brentru/greenhousecontroller/pcb/11_21 PCB/BOM.xlsx

Sheet: BOM (FINAL)
Category | Value | Package | Vendor | Part Number | Board Designation | Quantity | Unit Price | Total Cost
Capacitor | 0.01uF | C0805 | Digikey | 445-6947-1-ND (http://www.digikey.com/product-detail/en/CGA4C2C0G1H103J060AA/445-6947-1-ND/2672965) | C9 | 1 | $0.32 | $0.32
LED | Green | LED0805 | Digikey | 732-4986-1-ND (http://www.digikey.com/product-detail/en/150080VS75000/732-4986-1-ND/4489922) | LED7,LED8 | 2 | $0.29 | $0.58
LED | Blue | LED0805 | Digikey | 732-4982-1-ND (http://www.digikey.com/product-detail/en/150080BS75000/732-4982-1-ND/4489910) | LED3,LED4,LED5,LED6 | 4 | $0.29 | $1.16
LED | Red | LED0805 | Digikey | 732-4984-1-ND (http://www.digikey.com/product-detail/en/150080RS75000/732-4984-1-ND/4489916) | LED1,LED2 | 2 | $0.29 | $0.58
Resistor | 22Ω | R0805 | Digikey | P22.0CCT-ND (http://www.digikey.com/product-detail/en/ERJ-6ENF22R0V/P22.0CCT-ND/1746835) | R1,R2 | 2 | $0.10 | $0.20
Test | TPTP16SQ | Test | Digikey | A106144CT-ND (http://www.digikey.com/product-detail/en/1625854-2/A106144CT-ND/3477801) | TP1-TP23 | 25 | $0.23 | $5.70
 |  |  |  |  |  | Total Cost |  | $8.54
 |  |  |  |  |  | Cost for 1 Board |  | Figure It Out
 |  |  |  | COPY OF DIGIKEY CART

Sheet: Power Board
Category | Value | Package | Vendor | Part Number | Board Designation | Board | Quantity | Unit Price | Unit Cost | Checked
Resistor | 150 Ohm | R0805 | Digikey | RMCF0805JT150RCT-ND (http://www.digikey.com/product-detail/en/stackpole-electronics-inc/RMCF0805JT150R/RMCF0805JT150RCT-ND/1942541) | R1,R2, R4 | GreenHouse | 3 | $0.10 | $0.30 | yes
Resistor | 1k | R0805 | Digikey | RC0805JR-071KL (http://www.digikey.com/product-detail/en/yageo/RC0805JR-071KL/311-1.0KARCT-ND/731165) | R3,R7,R9,R12,R14,R15 | GreenHouse | 6 | $0.10 | $0.60 | yes
Resistor | 240 Ohm | R0805 | Digikey | RMCF0805JT240RCT-ND (http://www.digikey.com/product-detail/en/stackpole-electronics-inc/RMCF0805JT240R/RMCF0805JT240RCT-ND/1942545) | R8,R11 | GreenHouse | 2 | $0.10 | $0.20 | yes
Resistor | 3k | R0805 | Digikey | RMCF0805JT3K00CT-ND (http://www.digikey.com/product-detail/en/stackpole-electronics-inc/RMCF0805JT3K00/RMCF0805JT3K00CT-ND/1942566) | R13 | GreenHouse | 1 | $0.10 | $0.10 | yes
Resistor | 10k | R0805 | Digikey | RMCF0805JT10K0CT-ND (http://www.digikey.com/product-detail/en/stackpole-electronics-inc/RMCF0805JT10K0/RMCF0805JT10K0CT-ND/1942577) | R2,R5,R6 | GreenHouse | 3 | $0.10 | $0.30 | yes
Zener Diode | 15V | SOD-323F | Digikey | DZ2J150M0LCT-ND (http://www.digikey.com/product-detail/en/panasonic-electronic-components/DZ2J150M0L/DZ2J150M0LCT-ND/2269089) | D10 | GreenHouse | 1 | $0.10 | $0.10 | yes
Diode | 80V, 100mA | SOD-523 | Digikey | DA2S10100LCT-ND (http://www.digikey.com/product-detail/en/panasonic-electronic-components/DA2S10100L/DA2S10100LCT-ND/2193675) | D1,D2,D3,D4,D5,D6,D7,D11 | GreenHouse | 8 | $0.10 | $0.80 | yes
Diode | 75V | SOD-323F | Digikey | 1N4148WSFSCT-ND (http://www.digikey.com/product-detail/en/fairchild-semiconductor/1N4148WS/1N4148WSFSCT-ND/1873821) | D9 | GreenHouse | 1 | $0.15 | $0.15 | yes
Capacitor | 0.1uF | C0805 | Digikey | 311-1361-1-ND (http://www.digikey.com/product-detail/en/yageo/CC0805ZRY5V9BB104/311-1361-1-ND/2103145) | C4,C6,C7 | GreenHouse | 3 | $0.10 | $0.30 | yes
Capacitor | 1.0uF | C0805 | Digikey | 311-1365-1-ND (http://www.digikey.com/product-detail/en/yageo/CC0805KKX7R7BB105/311-1365-1-ND/2103149) | C3,C5 | GreenHouse | 2 | $0.10 | $0.20 | yes
Capacitor | 20.0pF | C0805 | Digikey | 1276-1829-1-ND (http://www.digikey.com/product-detail/en/samsung-electro-mechanics-america-inc/CL21C200JBANNNC/1276-1829-1-ND/3889915) | C1,C2 | GreenHouse | 2 | $0.10 | $0.20 | yes
Semiconductor | 30V, 60mA | SMD-DIP-6 | Mouser | 4N27S-M (http://www.mouser.com/ProductDetail/Fairchild-Semiconductor/4N27SM/?qs=6uASyQ2j9sdvrBgMHZPeqA%3D%3D) | OK1,OK2 | GreenHouse | 2 | $0.56 | $1.12 | yes
Transistor | 40V, 600 mA | SOT-23-3 | Digikey | MMBT2222A-FDICT-ND (http://www.digikey.com/product-detail/en/diodes-incorporated/MMBT2222A-7-F/MMBT2222A-FDICT-ND/815723) | Q1 | GreenHouse | 1 | $0.13 | $0.13 | yes
Push Button |  | SPST | Digikey | CW181-ND (http://www.digikey.com/product-detail/en/cw-industries/GPTS203211B/CW181-ND/3190590) | SW1 | GreenHouse | 1 | $0.74 | $0.74 | yes
Dual Full-Bridge Driver | 46V, 2A | 15-pin | Newark | L298N (http://www.newark.com/stmicroelectronics/l298n/motor-driver-full-bridge-2a-multiwatt15/dp/32M1527) | IC4 | GreenHouse | 1 | $8.85 | $8.85 | yes
Voltage Regulator | 33V-40V, 24V/1A | 3-pin | Newark | 29C4844 (http://www.newark.com/nte-electronics/nte972/linear-voltage-regulator-24v-to/dp/29C4844?rpsku=rel1%3A05H6137) | IC2 | GreenHouse | 1 | $1.55 | $1.55 | yes
Relay | 12VDC | Through-hole | Digikey | Z1015-ND (http://www.digikey.com/product-detail/en/omron-electronics-inc-emc-div/G5LE-1-DC12/Z1015-ND/280366?WT.srch=1) | K2 | GreenHouse | 1 | $1.33 | $1.33 | yes
Power Jack |  | 2.1mm/5.5mm | Digikey | EJ503A-ND (http://www.digikey.com/product-detail/en/mpd-memory-protection-devices/EJ503A/EJ503A-ND/5431753) | J1 | GreenHouse | 1 | $2.23 | $2.23 | yes
Screw Terminal |  | 3.5mm | Digikey | ED2636-ND (http://www.digikey.com/product-detail/en/on-shore-technology-inc/OSTTE030161/ED2636-ND/614585) | J2,J4,J5,J6,J7 | GreenHouse | 5 | $0.64 | $3.20 | yes
Screw Terminal |  | 5mm | Digikey | ED2601-ND (http://www.digikey.com/product-detail/en/on-shore-technology-inc/OSTTC030162/ED2601-ND/614550) | J3 | GreenHouse | 1 | $0.59 | $0.59 | yes
AVR ISP Header |  | 2x3-pin | Adafruit | #1465 (https://www.adafruit.com/products/1465?gclid=CIKw293bsNACFZBLDQodAlACig) | ICSP-PROG-HEADER | GreenHouse | 1 | $0.95 | $0.95 | yes
Crystal | 16MHz | HC-49 | Digikey | 535-10226-1-ND (http://www.digikey.com/product-detail/en/abracon-llc/ABLS-16.000MHZ-B4-T/535-10226-1-ND/2184261) | X1 | GreenHouse | 1 | $0.25 | $0.25 | yes
LED |  | CT | Digikey | 160-1423-1-ND (http://www.digikey.com/product-detail/en/lite-on-inc/LTST-C171GKT/160-1423-1-ND/386792) | LED3,LED4,LED5 | GreenHouse | 3 | $0.29 | $0.87 | yes
Heatsink |  | TO220 L298N | Amazon | 14004198 (https://www.amazon.com/12pcs-Aluminum-Heat-TO220-L298N/dp/B008XCNB2Q) |  | GreenHouse | 1 | $3.44 | $3.44 | yes
Female Header |  | 8x1-pin | Digikey | 609-3559-ND (http://www.digikey.com/product-detail/en/amphenol-fci/75915-308LF/609-3559-ND/1523940) | SV2,SV3 | GreenHouse | 2 | $1.16 | $2.32 | yes
FTDI Serial Header |  |  |  | #00834 (http://www.4uconnector.com/online/SearchPro.asp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) |  | GreenHouse | 1 | $1.00 | $1.00 | yes
 |  |  |  |  |  |  |  | Total | $31.82
