brentru/greenhousecontroller/pcb/11_21 PCB/ghc-silk.brd

## EAGLE design pcb/11_21 PCB/ghc-silk.brd (2016-11-22)

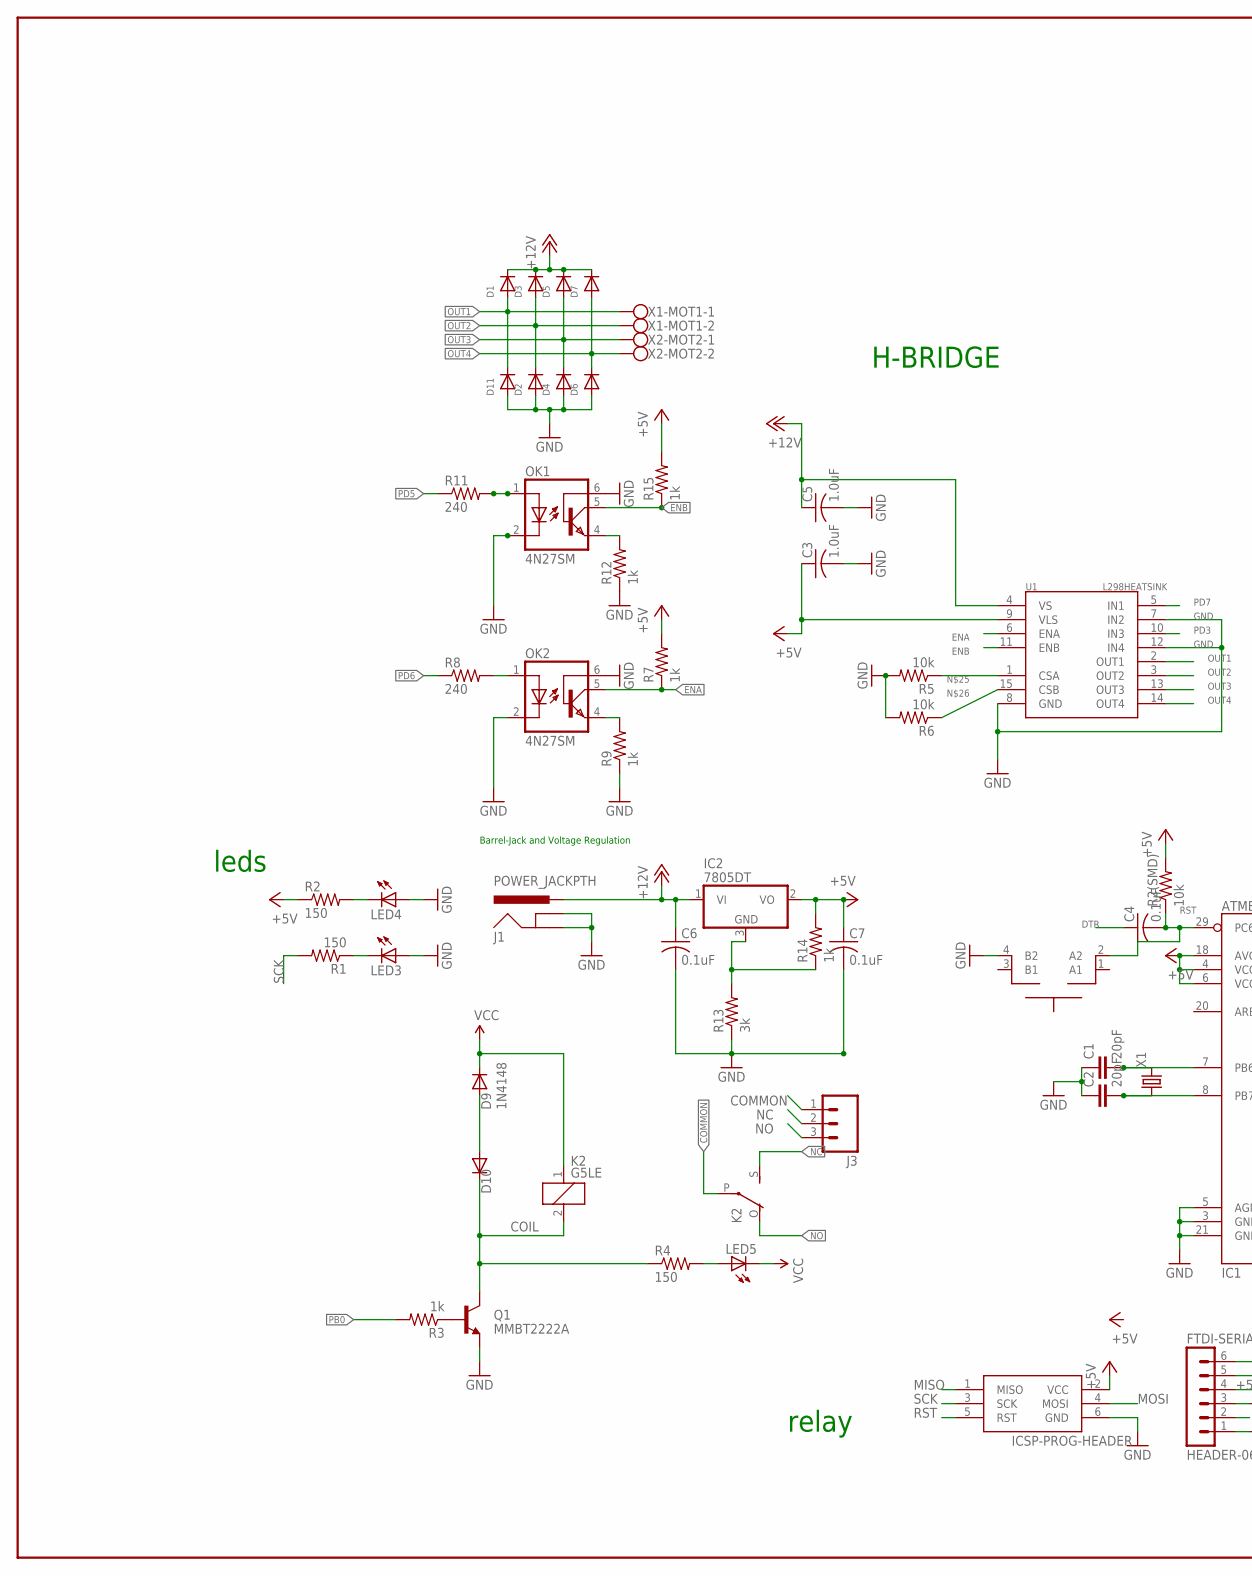
[picture p1: schematic ghc-silk.sch, part in row 1, column 1]

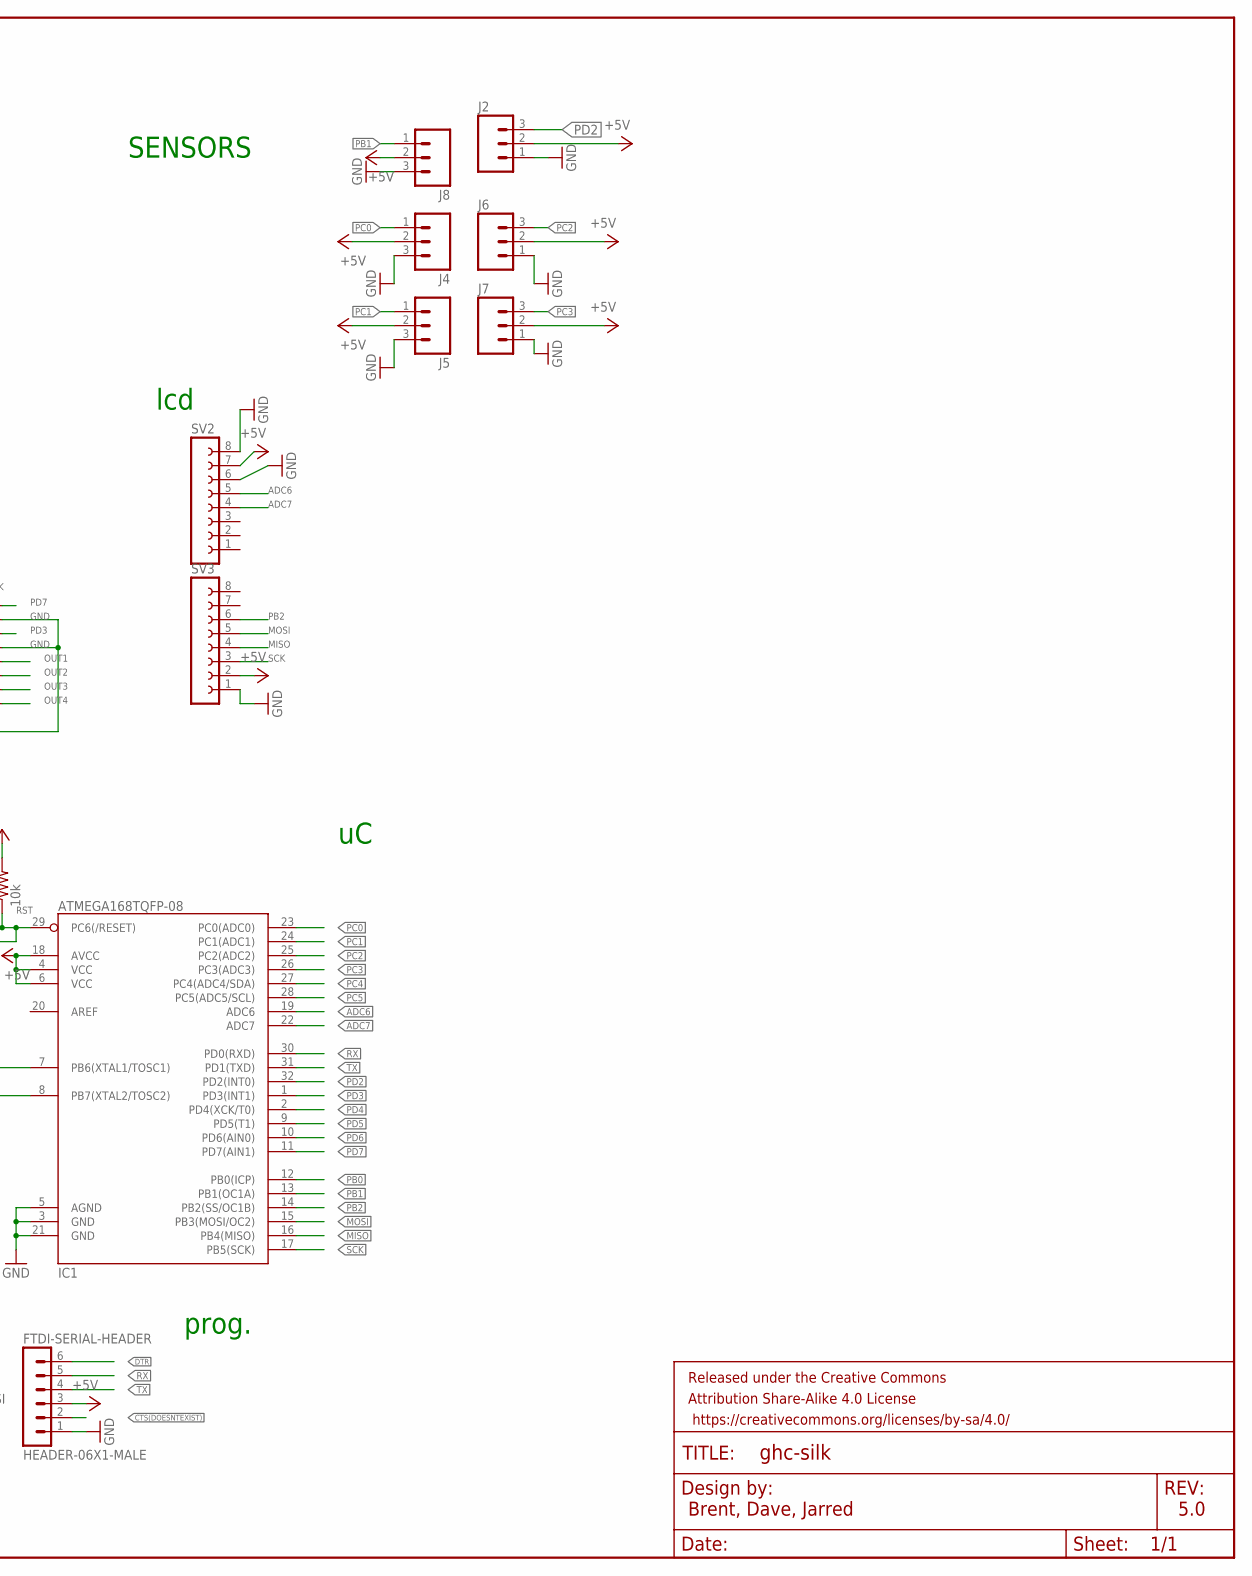
[picture p2: schematic ghc-silk.sch, part in row 1, column 2]

Parts:
C1, C2: 20pF; C0805
C3, C5: 1.0uF; C0805
C4, C6, C7: 0.1uF; C0805
D1, D2, D3, D4, D5, D6, D7, D11: DIODESOD-523; SOD-523
D9: 1N4148; SOD-323F
D10: Zener; SOD-323F
FRAME1: FRAME-LEDGER; CREATIVE_COMMONS
FTDI-SERIAL-HEADER: HEADER-06X1-MALE; 06X1-PTH
IC1: ATMEGA168TQFP-08; TQFP32-08
IC2: 7805DT; TO252
ICSP-PROG-HEADER: AVRISP-6; AVRISP
J1: POWER_JACKPTH; POWER_JACK_PTH
J2, J4, J5, J6, J7, J8: M03SCREW_LOCK; SCREWTERMINAL-3.5MM-3_LOCK.007S
J3: M03-SCREW-5MM; SCREWTERMINAL-5MM-3
K2: G5LE
LED3, LED4, LED5: LEDCHIP-LED0805; CHIP-LED0805
OK1, OK2: 4N27SM; DIL6-SMD
Q1: MMBT2222A; SOT23-3
R1, R2, R4: 150; M0805
R2(SMD), R5, R6: 10k; M0805
R3, R7, R9, R12, R14, R15: 1k; M0805
R8, R11: 240; M0805
R13: 3k; 0402-RES
SV2, SV3: FE08-1; FE08
SW2: MOMENTARYBUTTON; SPST_NO_SMD
U1: L298HEATSINK; MULTIWATT15_6400BGHEATSINK
X1: CRYSTALHC49UP; HC49UP
X1-MOT1, X2-MOT2: W237-102

Connections:
+5V: C3.1, C7.1, FTDI-SERIAL-HEADER.3, IC1.4 (VCC), IC1.6 (VCC), IC1.18 (AVCC), IC2.2 (VO), ICSP-PROG-HEADER.2 (VCC), J2.2, J4.2, J5.2, J6.2, J7.2, J8.2, R2.1, R2(SMD).2, R7.2, R14.2, R15.2, SV2.7, SV3.2, U1.9 (VLS)
+12V: C5.1, C6.1, D1.K (C), D3.K (C), D5.K (C), D7.K (C), IC2.1 (VI), J1.PWR, U1.4 (VS)
ADC6: IC1.19 (ADC6), SV2.5
ADC7: IC1.22 (ADC7), SV2.4
COIL: D10.C, K2.2, Q1.3 (C), R4.1
COMMON: J3.1, K2.P
CTS(DOESNTEXIST): FTDI-SERIAL-HEADER.2
DIODENODE: D9.A, D10.A
DTR: C4.1, FTDI-SERIAL-HEADER.6
ENA: OK2.5 (COL), R7.1, U1.6 (ENA)
ENB: OK1.5 (COL), R15.1, U1.11 (ENB)
GND: C1.1, C2.1, C3.2, C5.2, C6.2, C7.2, D2.A, D4.A, D6.A, D11.A, FTDI-SERIAL-HEADER.1, IC1.3 (GND), IC1.5 (AGND), IC1.21 (GND), ICSP-PROG-HEADER.6 (GND), J1.GND, J1.GNDBREAK, J2.1, J4.3, J5.3, J6.1, J7.1, J8.3, LED3.A, LED4.A, OK1.2 (C), OK1.6 (BAS), OK2.2 (C), OK2.6 (BAS), Q1.2 (E), R5.2, R6.2, R9.1, R12.1, R13.1, SV2.6, SV2.8, SV3.1, SW2.4 (B2), U1.7 (IN2), U1.8 (GND), U1.12 (IN4)
MISO: IC1.16 (PB4(MISO)), ICSP-PROG-HEADER.1 (MISO), SV3.4
MOSI: IC1.15 (PB3(MOSI/OC2)), ICSP-PROG-HEADER.4 (MOSI), SV3.5
unnamed: OK2.1 (A), R8.2
unnamed: LED4.C, R2.2
unnamed: LED5.A, R4.2
unnamed: OK2.4 (EMI), R9.2
unnamed: Q1.1 (B), R3.1
unnamed: IC2.3 (GND), R13.2, R14.1
unnamed: OK1.1 (A), R11.2
unnamed: LED3.C, R1.1
unnamed: C1.2, IC1.7 (PB6(XTAL1/TOSC1)), X1.2
unnamed: C2.2, IC1.8 (PB7(XTAL2/TOSC2)), X1.1
unnamed: OK1.4 (EMI), R12.2
unnamed: R5.1, U1.1 (CSA)
unnamed: R6.1, U1.15 (CSB)
NC: J3.2, K2.S
NO: J3.3, K2.O
OUT1: D1.A, D11.K (C), U1.2 (OUT1), X1-MOT1.1
OUT2: D2.K (C), D3.A, U1.3 (OUT2), X1-MOT1.2
OUT3: D4.K (C), D5.A, U1.13 (OUT3), X2-MOT2.1
OUT4: D6.K (C), D7.A, U1.14 (OUT4), X2-MOT2.2
PB0: IC1.12 (PB0(ICP)), R3.2
PB1: IC1.13 (PB1(OC1A)), J8.1
PB2: IC1.14 (PB2(SS/OC1B)), SV3.6
PC0: IC1.23 (PC0(ADC0)), J4.1
PC1: IC1.24 (PC1(ADC1)), J5.1
PC2: IC1.25 (PC2(ADC2)), J6.3
PC3: IC1.26 (PC3(ADC3)), J7.3
PC4: IC1.27 (PC4(ADC4/SDA))
PC5: IC1.28 (PC5(ADC5/SCL))
PD2: IC1.32 (PD2(INT0)), J2.3
PD3: IC1.1 (PD3(INT1)), U1.10 (IN3)
PD4: IC1.2 (PD4(XCK/T0))
PD5: IC1.9 (PD5(T1)), R11.1
PD6: IC1.10 (PD6(AIN0)), R8.1
PD7: IC1.11 (PD7(AIN1)), U1.5 (IN1)
RST: C4.2, IC1.29 (PC6(/RESET)), ICSP-PROG-HEADER.5 (RST), R2(SMD).1, SW2.2 (A2)
RX: FTDI-SERIAL-HEADER.5, IC1.30 (PD0(RXD))
SCK: IC1.17 (PB5(SCK)), ICSP-PROG-HEADER.3 (SCK), R1.2, SV3.3
TX: FTDI-SERIAL-HEADER.4, IC1.31 (PD1(TXD))
VCC: D9.C, K2.1, LED5.C

Notes on the sheet:
Barrel-Jack and Voltage Regulation
H-BRIDGE
lcd
SENSORS
prog.
relay
leds
5.0
Brent, Dave, Jarred

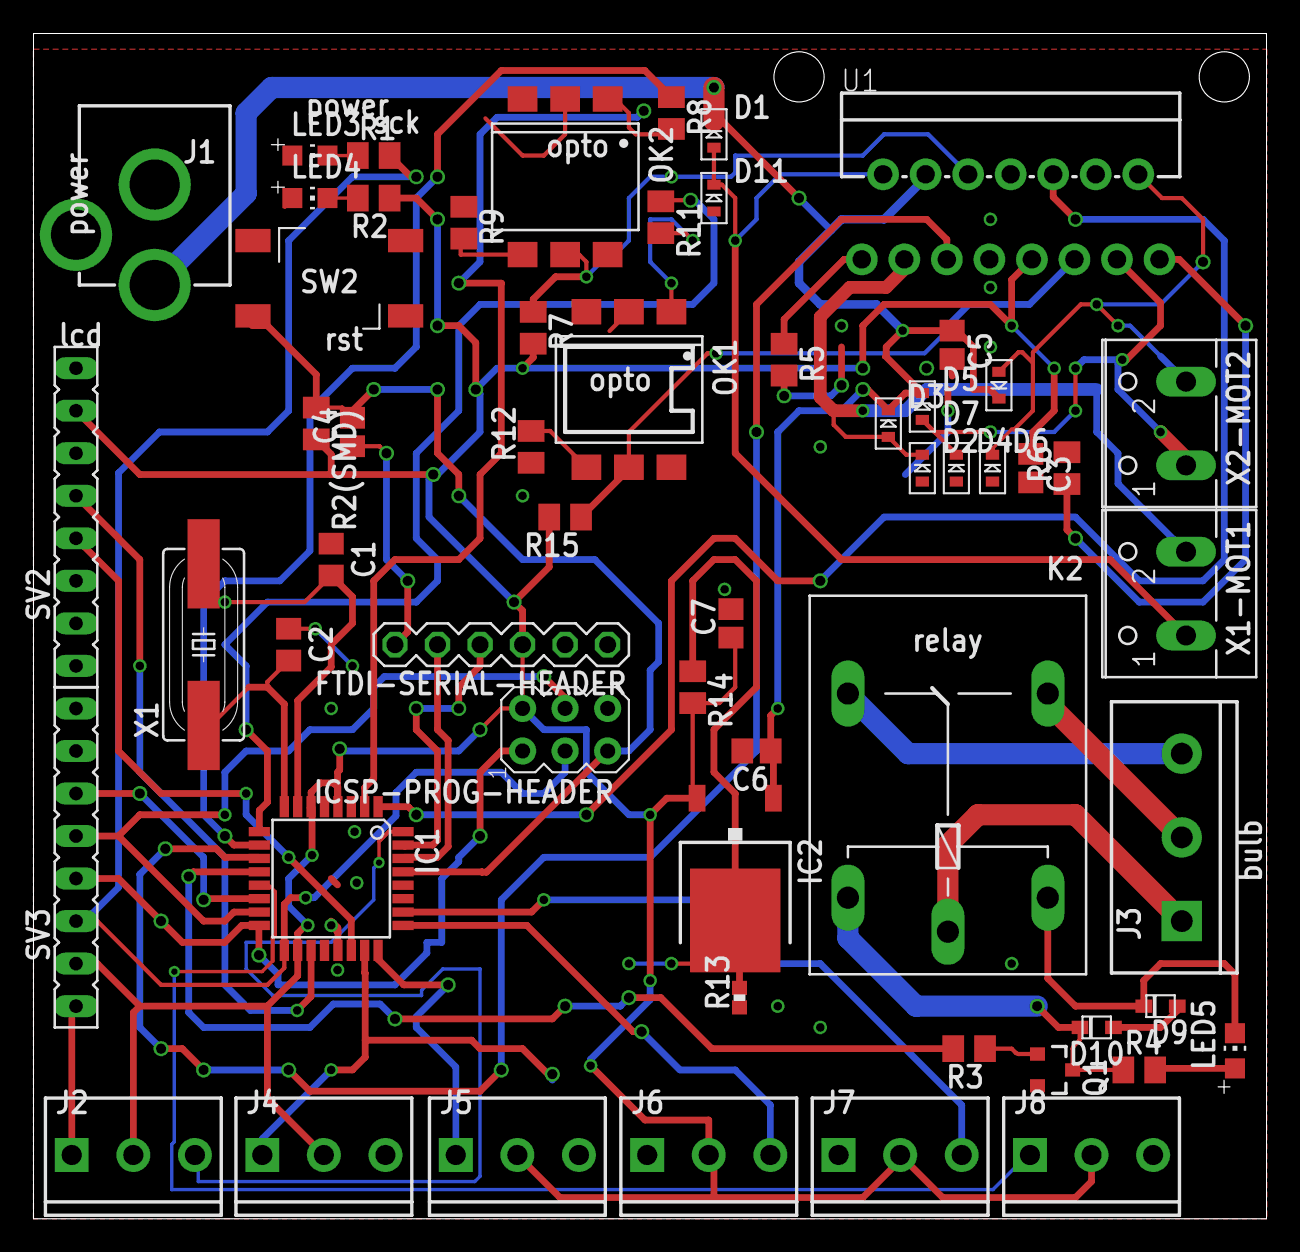
[picture p3: board ghc-silk.brd from above]

Board: 2 copper layers, 73.6 x 70.8 mm, 59 parts (0 on the bottom side), 49 nets.
