brentru/greenhousecontroller/DBJ/sb/sandbox/DBJ/outdated/greenhousectrl-lab.brd

## EAGLE design greenhousecontroller-master/DBJ/sb/sandbox/DBJ/outdated/greenhousectrl-lab.brd (2016-10-29, an earlier design)

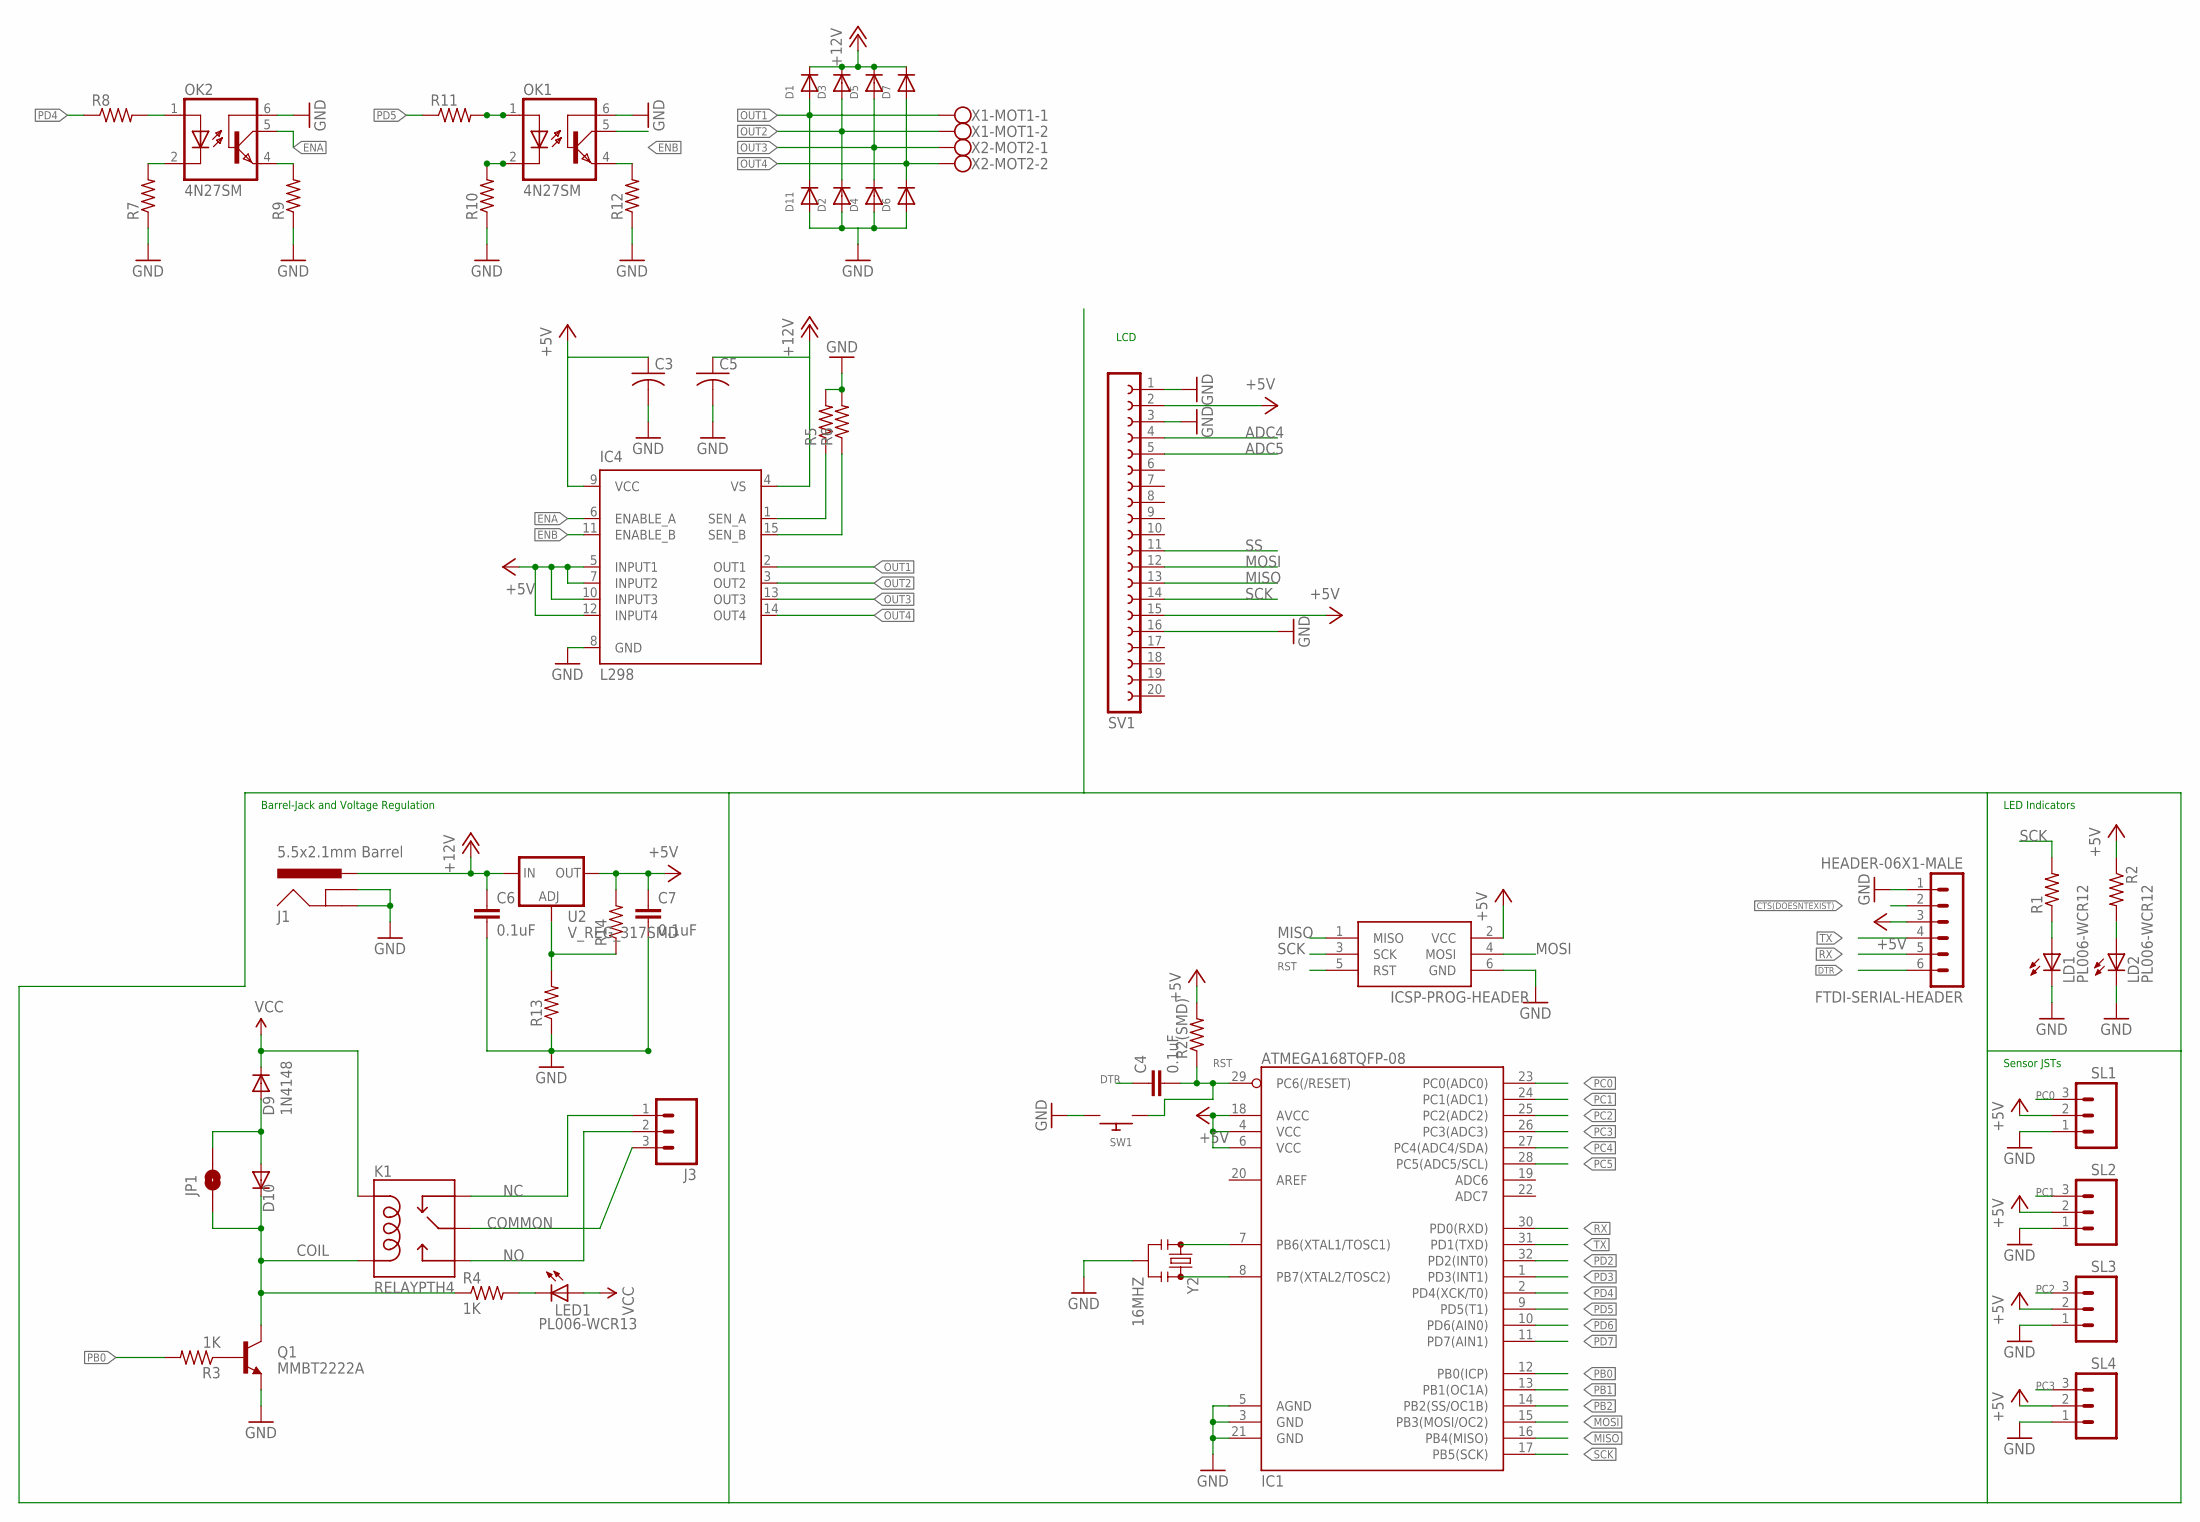
[picture p4: schematic greenhousectrl-lab.sch]

Parts:
C3, C5: C-US025-024X044; C025-024X044
C4, C6, C7: 0.1uF; 0603-CAP
D1, D2, D3, D4, D5, D6, D7, D11: DIODESOD-523; SOD-523
D9: 1N4148; SOD-323F
D10: Zener; SOD-323F
FTDI-SERIAL-HEADER: HEADER-06X1-MALE; 06X1-PTH
IC1: ATMEGA168TQFP-08; TQFP32-08
IC4: L298; MULTIWATT-15
ICSP-PROG-HEADER: AVRISP-6; AVRISP
J1: 5.5x2.1mm Barrel; POWER_JACK_SMD
J3: M03-SCREW-5MM; SCREWTERMINAL-5MM-3
JP1: JUMPER-PAD-2-NOYES_SILK; PAD-JUMPER-2-NO_YES_SILK
K1: RELAYPTH4; RELAY-JZC
LD1, LD2: PL006-WCR12; SOT23
LED1: PL006-WCR13; SOT23
OK1, OK2: 4N27SM; DIL6-SMD
Q1: MMBT2222A; SOT23-3
R1, R2, R2(SMD), R5, R6, R7, R8, R9, R10, R11, R12: R-US_M0805; M0805
R3, R4: 1K; M0805
R13, R14: RESISTOR0402; 0402-RES
SL1, SL2, SL3, SL4: M03; 03P
SV1: FE20-1; FE20
SW1: SWITCH_PUSHBUTTONC&K_KSS; BTN_CK_KSS
U2: V_REG_317SMD; SOT223
X1-MOT1, X2-MOT2: W237-102
Y2: 16MHZ; RESONATOR-SMD

Connections:
+5V: C3.1, C7.1, FTDI-SERIAL-HEADER.3, IC1.4 (VCC), IC1.6 (VCC), IC1.18 (AVCC), IC4.5 (INPUT1), IC4.7 (INPUT2), IC4.9 (VCC), IC4.10 (INPUT3), IC4.12 (INPUT4), ICSP-PROG-HEADER.2 (VCC), R2.1, R2(SMD).2, R14.2, SL1.2, SL2.2, SL3.2, SL4.2, SV1.2, SV1.15, U2.2 (OUT)
+12V: C5.1, C6.1, D1.K (C), D3.K (C), D5.K (C), D7.K (C), IC4.4 (VS), J1.VIN0 (PWR), U2.3 (IN)
ADC4: SV1.4
ADC5: SV1.5
COIL: D10.C, JP1.1, K1.1 (COIL2), Q1.3 (C), R4.1
COMMON: J3.3, K1.4 (MAIN)
CTS(DOESNTEXIST): FTDI-SERIAL-HEADER.2
DIODENODE: D9.A, D10.A, JP1.2
DTR: C4.1, FTDI-SERIAL-HEADER.6
ENA: IC4.6 (ENABLE_A), OK2.5 (COL)
ENB: IC4.11 (ENABLE_B), OK1.5 (COL)
GND: C3.2, C5.2, C6.2, C7.2, D2.A, D4.A, D6.A, D11.A, FTDI-SERIAL-HEADER.1, IC1.3 (GND), IC1.5 (AGND), IC1.21 (GND), IC4.8 (GND), ICSP-PROG-HEADER.6 (GND), J1.GND (GNDBREAK), J1.P$4 (GND), LD1.3 (C), LD2.3 (C), OK1.6 (BAS), OK2.6 (BAS), Q1.2 (E), R5.2, R6.2, R7.1, R9.1, R10.1, R12.1, R13.1, SL1.1, SL2.1, SL3.1, SL4.1, SV1.1, SV1.3, SV1.16, SW1.P$2, Y2.2
MISO: IC1.16 (PB4(MISO)), ICSP-PROG-HEADER.1 (MISO), SV1.13
MOSI: IC1.15 (PB3(MOSI/OC2)), ICSP-PROG-HEADER.4 (MOSI), SV1.12
unnamed: OK2.1 (A), R8.2
unnamed: LD2.1 (A), R2.2
unnamed: LED1.3 (C), R4.2
unnamed: OK2.2 (C), R7.2
unnamed: OK2.4 (EMI), R9.2
unnamed: Q1.1 (B), R3.1
unnamed: R13.2, R14.1, U2.1 (ADJ)
unnamed: OK1.1 (A), R11.2
unnamed: OK1.2 (C), R10.2
unnamed: LD1.1 (A), R1.1
unnamed: IC1.7 (PB6(XTAL1/TOSC1)), Y2.1
unnamed: OK1.4 (EMI), R12.2
unnamed: IC1.8 (PB7(XTAL2/TOSC2)), Y2.3
NC: J3.1, K1.2 (NC)
NO: J3.2, K1.3 (NO)
OUT1: D1.A, D11.K (C), IC4.2 (OUT1), X1-MOT1.1
OUT2: D2.K (C), D3.A, IC4.3 (OUT2), X1-MOT1.2
OUT3: D4.K (C), D5.A, IC4.13 (OUT3), X2-MOT2.1
OUT4: D6.K (C), D7.A, IC4.14 (OUT4), X2-MOT2.2
PB0: IC1.12 (PB0(ICP)), R3.2
PB1: IC1.13 (PB1(OC1A))
PB2: IC1.14 (PB2(SS/OC1B))
PC0: IC1.23 (PC0(ADC0)), SL1.3
PC1: IC1.24 (PC1(ADC1)), SL2.3
PC2: IC1.25 (PC2(ADC2)), SL3.3
PC3: IC1.26 (PC3(ADC3)), SL4.3
PC4: IC1.27 (PC4(ADC4/SDA))
PC5: IC1.28 (PC5(ADC5/SCL))
PD2: IC1.32 (PD2(INT0))
PD3: IC1.1 (PD3(INT1))
PD4: IC1.2 (PD4(XCK/T0)), R8.1
PD5: IC1.9 (PD5(T1)), R11.1
PD6: IC1.10 (PD6(AIN0))
PD7: IC1.11 (PD7(AIN1))
RST: C4.2, IC1.29 (PC6(/RESET)), ICSP-PROG-HEADER.5 (RST), R2(SMD).1, SW1.P$1
RX: FTDI-SERIAL-HEADER.5, IC1.30 (PD0(RXD))
SCK: IC1.17 (PB5(SCK)), ICSP-PROG-HEADER.3 (SCK), R1.2, SV1.14
SEN_A: IC4.1 (SEN_A), R5.1
SEN_B: IC4.15 (SEN_B), R6.1
SS: SV1.11
TX: FTDI-SERIAL-HEADER.4, IC1.31 (PD1(TXD))
VCC: D9.C, K1.5 (COIL1), LED1.1 (A)

Notes on the sheet:
Sensor JSTs
Barrel-Jack and Voltage Regulation
LED Indicators
LCD

Board: 2 copper layers, 54 parts (0 on the bottom side), 44 nets, no tracks yet.
