brentru/greenhousecontroller/(commit log)

2016-10-20 Add files via upload
    Still working on the schematic for the chip, this is what I have so far
2016-10-21 thursnightchanges
    added jsts area, redid labels on right side of chip
    [OCT19.brd, OCT19.sch]
2016-10-23 Hbridge
    entire hbridge circuit, changed any remaining thru-hole to smd, used a
    different hbridge, organized the schematic,
    [OCT19.sch]
2016-10-23 Add files via upload
    Redid the crystal wiring, and edited the RST of the ICSP
    [OCT19.sch]
2016-10-24 sunday changes
    added a push button to pc6/reset for human-interaction with the reset
    line
    [OCT19.brd, OCT19.sch]
2016-10-24 removed octocouplers
    Removed octocouplers due to redundancy. IC can handle 12V and 5V, won’t
    fry anything.
2016-10-24 Add files via upload
    First attempt: Created nets, named them after the appropriate microcontroller connections, and "wired" them to a 20-pin female header for IDE.
2016-10-25 Add files via upload
    Updated with the assistance from Dave, as well as with the relay setup.
2016-10-25 rev 0.0.1 of schematic
    first rev of full schematic capture
    [greenhousectrl.sch]
2016-10-27 in-lab sync
    [Oct20.sch, greenhousectrl-lab.sch]
2016-10-27 Optocouplers
    hbridge now has a better octocoupler circuit attached
2016-10-27 board updated
    traces added for flyback diodes
    [greenhousectrl-lab.brd, greenhousectrl-lab.sch]
2016-10-29 Updated Schematic Notes
    smaller relay, smd parts added for leds instead of thru-hole, smaller
    diodes for h-bridge
    [OCT19.brd, greenhousectrl-lab.brd, greenhousectrl-lab.sch, greenhousectrl-latest.brd, greenhousectrl-latest.sch, greenhousectrl.brd, greenhousectrl.sch]
2016-10-29 Updated Schematic
    clearly shows subsystems for pcb layout
    [greenhousectrl-latest.brd, greenhousectrl-latest.sch]
2016-11-02 In Lab changes
    [greenhousectrl-latest.brd]
2016-11-02 Expansion of Board
    Worked on reorganizing the h-bridge and components
    [greenhousectrl-latest.brd, greenhousectrl-latest.sch]
2016-11-02 Reorg of files and added expanded board design
    [greenhousectrl-latest-compressed.brd, greenhousectrl-latest-compressed.sch, greenhousectrl-latest-expanded.brd, greenhousectrl-latest-expanded.sch]
2016-11-04 Updated power jack / caps, routed h-bridge and components
    [greenhousectrl-latest-expanded.brd, greenhousectrl-latest.brd, greenhousectrl-latest.sch]
2016-11-04 replaced parts to conform with preferred part list
    [greenhousectrl-latest-expanded.brd, greenhousectrl-latest-expanded.sch]
2016-11-06 Saturday Update
    routed/organized: voltage regulator, barrel jack, relay
    [greenhousectrl-lab.brd, greenhousectrl-lab.sch, greenhousectrl-latest-compressed.brd, greenhousectrl-latest-compressed.sch, greenhousectrl-latest-expanded-RELAY-HBRIDGE-VOLTAGESTUFFS.brd, greenhousectrl-latest-expanded-RELAY-HBRIDGE-VOLTAGESTUFFS.sch, greenhousectrl-latest-expanded.brd, greenhousectrl-latest-expanded.sch]
2016-11-06 Compressed the components near and around h-bridge
    [greenhousectrl-latest-shrunkenHBridge.brd, greenhousectrl-latest-shrunkenHBridge.sch]
2016-11-06 Saturday Update
    Board sz reduction. uC, sensors, and GND needs to be routed. Ground
    plane (top/bot) added.
    [greenhousectrl-latest-saturday.brd, greenhousectrl-latest-saturday.sch]
2016-11-07 erc and new vreg
    ran erc on schematic, re-organized repository, used 7824DTvreg instead
    of the vreg previously used due to erc giving errors
    [greenhousectrl-lab.brd, greenhousectrl-lab.sch, greenhousectrl-latest-compressed.brd, greenhousectrl-latest-compressed.sch, greenhousectrl-latest-expanded-RELAY-HBRIDGE-VOLTAGESTUFFS.brd, greenhousectrl-latest-expanded-RELAY-HBRIDGE-VOLTAGESTUFFS.sch, greenhousectrl-latest-expanded.brd, greenhousectrl-latest-expanded.sch]
2016-11-07 Ran Dirty8TS, fixed wiring and angle errors
2016-11-07 no drc errors
    [greenhousectrl-latest-monday-no-errors-fixed-cap.brd, greenhousectrl-latest-monday-no-errors-fixed-cap.sch]
2016-11-07 Swapped out sensor pins
    [greenhousectrl-latest-monday-no-errors-fixed-cap.GBL, greenhousectrl-latest-monday-no-errors-fixed-cap.GBO, greenhousectrl-latest-monday-no-errors-fixed-cap.GBS, greenhousectrl-latest-monday-no-errors-fixed-cap.GKO, greenhousectrl-latest-monday-no-errors-fixed-cap.GTL, greenhousectrl-latest-monday-no-errors-fixed-cap.GTO, greenhousectrl-latest-monday-no-errors-fixed-cap.GTP, greenhousectrl-latest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]
2016-11-08 Replaced 1x20 LCD with 2 1x8, gerb and DRC checked
    [greenhousectrl-latest-monday-no-errors-fixed-cap.brd, greenhousectrl-latest-monday-no-errors-fixed-cap.sch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]
2016-11-08 Fixed Orientation of Jack, New Gerb Files and Updated Folder for Viall
    [greenhousectrl-latest-monday-redo.brd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]
2016-11-08 production files first ul
    [ghc-bom.csv, ghc-silk.brd, ghc-silk.sch, greenhousectrl-latest-saturdayf.brd, greenhousectrl-latest-saturdayf.sch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]
2016-11-08 Redid Gerbv and Gerbers, Created Folder for Items Viall Requested
    [ghc-bom.csv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]
2016-11-19 Moved Most Recent Board Design and Gerbers with thebom into git
    [BOM.xlsx, ghc-bom.csv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]
2016-11-19 Moved Components on Right side down for heat sink, added drill holes for heat sink
    [ghc-silk.sch]
2016-11-19 Updated Gerbv and Gerber Files, Copied Folder to Google Drive
    [ghc-silk.GBL, ghc-silk.GBS, ghc-silk.GKO, ghc-silk.GTL, ghc-silk.GTO, ghc-silk.GTP, ghc-silk.GTS]
2016-11-21 Fixed Traces
    [ghc-silk.brd, ghc-silk.sch]
2016-11-21 Replaced H-bridge, remapped pins where needed. Needs routing still
    [BOM.csv, ghc-silk.brd, ghc-silk.sch]
2016-11-22 Finalized with Gerbers and Gerbv along with Updated BOM
    Sent to Ben, for production of board
    [BOM.csv, BOM.xlsx, ghc-bom.csv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]
2016-11-22 Added Frame Ledger
2016-11-29 file directories moved
    [BOM.csv, BOM.xlsx, ghc-bom.csv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]
2017-03-15 cleaned up repo
    [BOM.csv, BOM.xlsx, ghc-bom.csv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]
